oturpe/crystal-c-levitation/resources/wiki/schematics/magnet-above-feedback.jpg

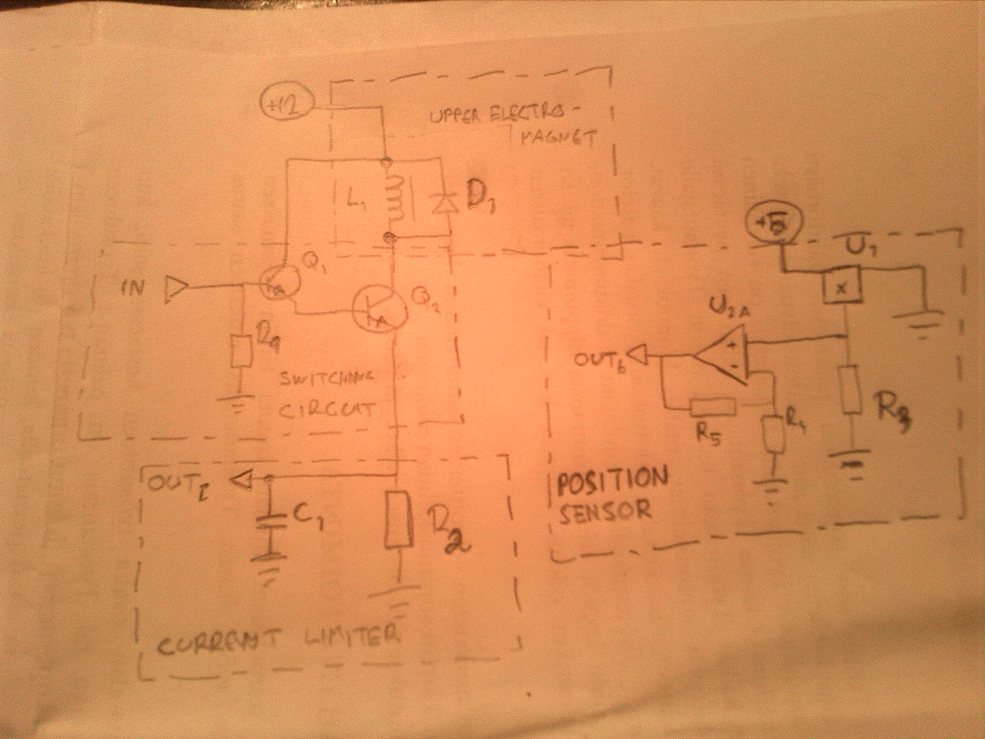
resources/wiki/schematics/magnet-above-feedback.jpg
