oturpe/crystal-c-levitation/resources/wiki/schematics/driver.jpg

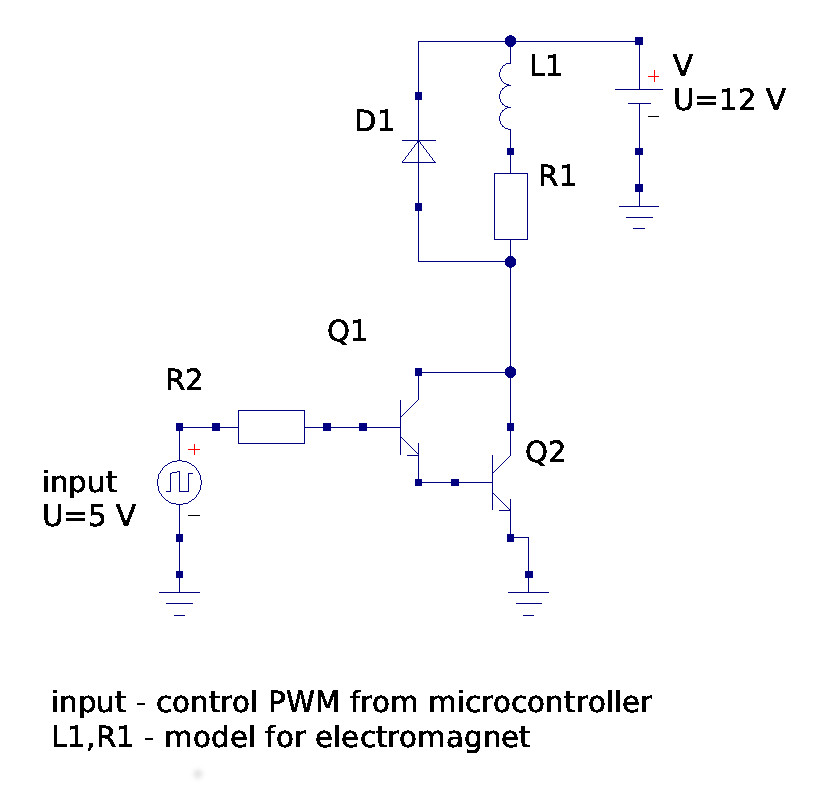
resources/wiki/schematics/driver.jpg
