oturpe/crystal-c-levitation/resources/wiki/schematics/sensor.jpg

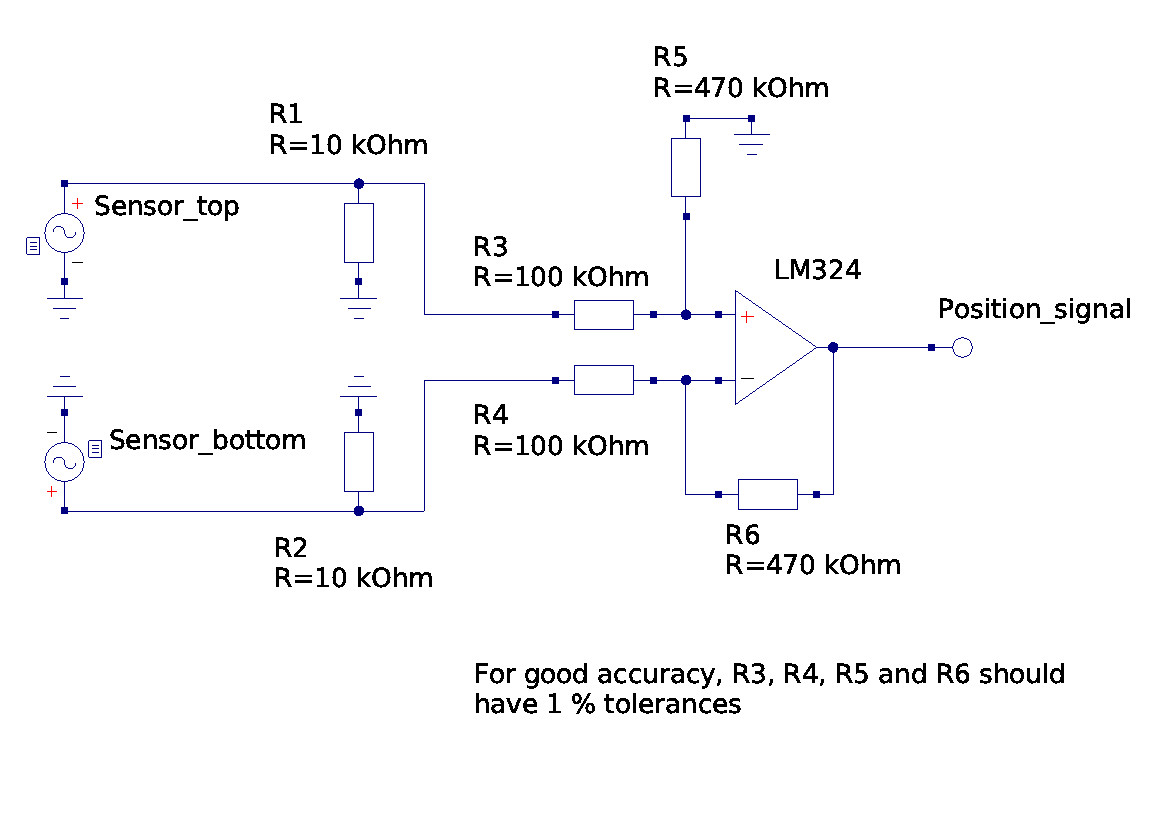
resources/wiki/schematics/sensor.jpg
