oturpe/crystal-c-levitation/resources/wiki/test-results/magnets.ods

id | wire | Resistance (Ω) | turns | Ratio (Ω/100 turns) | core Ø (mm) | Inductance (μH) | Notes
0/1 | broken power supply, thinner | 1,0 | 200 | 0,500 | 4
0/2 | broken power supply, thinner | 2,5 | 515 | 0,485 | 4 |  | Extension of the previous one
1/1 | Ø 0,2 mm | 7,7 | 515 | 1,495 | 3 |  | Too hot at 440 mA?
1/2 | Ø 0,2 mm | 23,5 | 1500 | 1,567 | 3
2/1 | Ø 0,4 mm | 15,0 | 2010 | 0,746 | 5
3/1 | Ø 0,6 mm | 9,4 | 1850 | 0,508 | 5 | 23 (assume air core)
4/1 | Ø 1,0 mm | 4,2 | ? | #ARVO! | 9
4/2 | Ø 1,0 mm | 4,2 | 1630 | 0,258 | 10 |  | Adjustable core
4/3 | Ø 1,0 mm | 8,1 | 2540 | 0,319 | 10 |  | Adjustable core. Extension of the previous one
 |  |  |  | #JAKO/0!
 |  |  |  | #JAKO/0!
 |  |  |  | #JAKO/0!
 |  |  |  | #JAKO/0!
 |  |  |  | #JAKO/0!
 |  |  |  | #JAKO/0!
 |  |  |  | #JAKO/0!
 |  |  |  | #JAKO/0!
 |  |  |  | #JAKO/0!
 |  |  |  | #JAKO/0!
 |  |  |  | #JAKO/0!
 |  |  |  | #JAKO/0!
 |  |  |  | #JAKO/0!
 |  |  |  | #JAKO/0!
 |  |  |  | #JAKO/0!
 |  |  |  | #JAKO/0!
 |  |  |  | #JAKO/0!
