oturpe/crystal-c-levitation/resources/wiki/test-results/two_sensors.ods

Readings from both bottom and top Hall effect sensors using various duty cycle values.
Difference between these values is also reported. In ideal situation the difference is always zero.
Positioning of the sensors was done by first putting top one in the center and then matching bottom one so that values were as close as possible at 255 duty cycle.
Magnet used was 3/1, supply voltage 12 V.
duty cycle | bottom position | top position | diff
0 | 505 | 519 | 14
5 | 505 | 519 | 14
10 | 510 | 525 | 15
15 | 512 | 530 | 18
20 | 515 | 534 | 19
25 | 519 | 539 | 20
30 | 522 | 544 | 22
35 | 527 | 550 | 23
40 | 531 | 555 | 24
45 | 536 | 560 | 24
50 | 541 | 565 | 24
55 | 547 | 571 | 24
60 | 552 | 576 | 24
65 | 558 | 581 | 23
70 | 565 | 586 | 21
75 | 571 | 591 | 20
80 | 577 | 596 | 19
85 | 583 | 601 | 18
90 | 590 | 607 | 17
95 | 596 | 611 | 15
100 | 602 | 616 | 14
105 | 608 | 621 | 13
110 | 614 | 626 | 12
115 | 620 | 630 | 10
120 | 626 | 635 | 9
125 | 631 | 640 | 9
130 | 637 | 644 | 7
135 | 642 | 649 | 7
140 | 648 | 653 | 5
145 | 653 | 657 | 4
150 | 658 | 662 | 4
155 | 663 | 666 | 3
160 | 668 | 670 | 2
165 | 672 | 675 | 3
170 | 676 | 678 | 2
175 | 681 | 682 | 1
180 | 685 | 687 | 2
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
