oturpe/crystal-c-levitation/resources/wiki/test-results/position_pwm.ods

Position readings using various PWM frequencies as allowed by AVR
Values starting from 31250 and going down were taken using the same PWM pin (11) and reducing timer frequency
As maximum PWM frequency of pin 11 was 31250, values for 62500 were taken from pin 6
Note how variance of change attains its minumum at 3906 Hz
Variance is also calculated for range of 200-255 only as it is probably a good idea to drive magnet near full power at all times so as to get along with smaller magnet
duty cycle | Position 62500 | Position 31250 | Position 3906 | Position 977 | Position 488 | Position 122 | Δ 62500 | Δ 31250 | Δ 3906 | Δ 977 | Δ 488 | Δ 122
0 | 508 | 507 | 508 | 508 | 508 | 507
5 | 508 | 508 | 508 | 508 | 508 | 507 | 0 | 1 | 0 | 0 | 0 | 0
10 | 514 | 516 | 512 | 510 | 510 | 510 | 6 | 8 | 4 | 2 | 2 | 3
15 | 520 | 523 | 515 | 514 | 514 | 514 | 6 | 7 | 3 | 4 | 4 | 4
20 | 527 | 529 | 519 | 518 | 516 | 516 | 7 | 6 | 4 | 4 | 2 | 2
25 | 533 | 535 | 524 | 521 | 520 | 523 | 6 | 6 | 5 | 3 | 4 | 7
30 | 539 | 539 | 528 | 526 | 526 | 527 | 6 | 4 | 4 | 5 | 6 | 4
35 | 545 | 545 | 533 | 530 | 529 | 527 | 6 | 6 | 5 | 4 | 3 | 0
40 | 551 | 549 | 538 | 534 | 533 | 537 | 6 | 4 | 5 | 4 | 4 | 10
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
