oturpe/crystal-c-levitation/resources/wiki/test-results/position_2-1.ods

This table contains position readings directly from sensor connected right on the end of magnet 2/1.
U= 20V, PWM frequency = 122 Hz
Position ↑ is when text on the sensor (SE49) points toward the magnet core. Position ↓ is the opposite.
Quiescent reading is position reading when electromagnet is not powered.
Deviation is difference from quiescent reading.
Δ is change in value since the last reading.
Notice how absolute value of Δ varies with duty cycle, but is same for both ↑ and ↓. Duty cycle.
This means that sensor in accurate, but magnetic field changes in a complicated way related to duty cycle.
Suspect: Timings of duty cycle and sensor reads interfere,
Suggestion 1: Increase PWM frequency (careful not to deprive electromagnet of time to release current!)
Suggestion 2: When reading the sensor, take multiple readings & average out.
quiescent | 507
duty cycle | Position ↑ | Position ↓ | Deviation ↑ | Deviation ↓ | Δ ↑ | Δ ↓ | Sum of deviations
0 | 507 | 507 | 0 | 0 |  |  | 0
10 | 507 | 507 | 0 | 0 | 0 | 0 | 0
20 | 501 | 511 | 6 | -4 | -6 | 4 | 2
30 | 489 | 523 | 18 | -16 | -12 | 12 | 2
40 | 470 | 542 | 37 | -35 | -19 | 19 | 2
50 | 473 | 539 | 34 | -32 | 3 | -3 | 2
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
