oturpe/crystal-c-levitation/resources/wiki/test-results/position_avg.ods

Position readings got by using different amount of smoothing of sensor readings.
In each case, sensor was read repeatedly with 10 ms intervals. Readings were taken 1, 2, 3, 4, 5, 6, 10 or 20 times.
Listed are raw position values got this way and differential between two subsequent values of duty cycle.
The interesting result is the variance of readings.
Results seem to indicate that some amount of smoothing is useful, but the effect is not huge.
duty cycle | Position 1 | Position 2 | Position 3 | Position 4 | Position 5 | Position 6 | Position 10 | Position 20 | Δ 1 | Δ 2 | Δ 3 | Δ 4 | Δ 5 | Δ 6 | Δ 10 | Δ 20
0 | 507 | 507 | 507 | 506 | 507 | 506 | 506 | 507
5 | 507 | 506 | 505 | 505 | 504 | 504 | 503 | 501 | 0 | -1 | -2 | -1 | -3 | -2 | -3 | -6
10 | 499 | 499 | 499 | 498 | 498 | 497 | 497 | 496 | -8 | -7 | -6 | -7 | -6 | -7 | -6 | -5
15 | 494 | 495 | 494 | 494 | 493 | 493 | 492 | 492 | -5 | -4 | -5 | -4 | -5 | -4 | -5 | -4
20 | 490 | 490 | 490 | 490 | 488 | 488 | 488 | 487 | -4 | -5 | -4 | -4 | -5 | -5 | -4 | -5
25 | 485 | 486 | 485 | 485 | 483 | 483 | 483 | 482 | -5 | -4 | -5 | -5 | -5 | -5 | -5 | -5
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
