oturpe/crystal-c-levitation/resources/wiki/test-results/field_strength.ods

Both bottom and top position readings using various supply voltages.
Magnet used was 3/1, supply voltages 12 V, 20 V and 27 V were used.
Notice how position difference values depend on magnetic fied strength (i.e. In all tests smallest difference appeared around position 700).
This may be because sensor positions were calibrated using field of that strength.
Also note the plot below showing how after value 700 readings smoothly change slower.
Reason for this change might be: i) high coil inductance, ii) sensor nonlinearity, iii) core saturation
duty cycle | bottom pos 12 | top pos 12 | pos diff 12 | Δ b pos 12 | bottom pos 20 | top pos 20 | pos diff 20 | Δ b pos 20 | bottom pos 27 | top pos 27 | pos diff 27 | Δ b pos 27
0 | 507 | 520 | -13 |  | 506 | 520 | -14 |  | 507 | 520 | -13
5 | 507 | 520 | -13 | 0 | 506 | 520 | -14 | 0 | 507 | 521 | -14 | 0
10 | 510 | 526 | -16 | 3 | 514 | 532 | -18 | 8 | 518 | 537 | -19 | 11
15 | 513 | 530 | -17 | 3 | 520 | 541 | -21 | 6 | 526 | 548 | -22 | 8
20 | 516 | 534 | -18 | 3 | 527 | 550 | -23 | 7 | 536 | 558 | -22 | 10
25 | 519 | 539 | -20 | 3 | 536 | 559 | -23 | 9 | 547 | 569 | -22 | 11
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
