oturpe/crystal-c-levitation/src/main.cpp

// Precompiled library dependencies
#include "Arduino.h"
#include "new.h"

// Source library dependencies
#include "lib/ArduinoPwm.h"

// Project configuration
#include "CrystalCLevitation.h"

// In-project dependencies
#include "PositionSensor.h"
#include "RingDriver.h"
#include "Controller.h"

RingDriver ringDriver(RING_PIN);
PositionSensor positionSensor(SENSOR_PIN,SENSOR_RESET_PIN);
Controller controller(CONTROLLER_PIN_OP,CONTROLLER_PIN_COEFF);

int loopCount = 0;

// The setup() method runs once, when the sketch starts
void setup() {
   #ifdef __DEBUG
       Serial.begin(DEBUG_PRINT_BAUDRATE);
   #endif

   setPwmFrequency(RING_PIN,PWM_SCALING);

   ringDriver.init();

   // Header line for CSV debug output
   #ifdef __DEBUG
       Serial.println("position;duty cycle;");
   #endif
}

// the loop() method runs over and over again, as long as the Arduino has power.
void loop() {
    loopCount += 1;

    if(loopCount % CONTROLLER_PARAM_UPDATE_INTERVAL == 0) {
        controller.readParameters();
        positionSensor.readParameters();
    }

    int position = positionSensor.read();
    int level = controller.control(position);

    ringDriver.drive(level);

    // Add line to CSV debug output
    #ifdef __DEBUG
        if (loopCount % DEBUG_PRINT_INTERVAL == 0) {
            Serial.print(position);
            Serial.print(";");
            Serial.print(level);
            Serial.print(";");

            Serial.println("");
        }
    #endif
}

int main(void) {

    init();
    setup();

    while (true) {
        loop();
    }
}
