oturpe/crystal-c-levitation/src/RingDriver.cpp

/*
 * RingDriver.cpp
 *
 *  Created on: 5.11.2013
 *      Author: Otto Urpelainen
 */

#include "Arduino.h"

#include "CrystalCLevitation.h"

#include "RingDriver.h"

RingDriver::RingDriver(int ringPin): ringPin(ringPin) {
}

void RingDriver::init() {
    pinMode(ringPin,OUTPUT);
    analogWrite(ringPin,0);
}

void RingDriver::drive(int dutyCycle) {
    analogWrite(ringPin,dutyCycle);
}

RingDriver::RingDriver() {
}
