oturpe/crystal-c-levitation/(commit log)

2013-11-03 Init as AVR project that uses the Arduino Core library.
2013-11-04 Add schematics
2013-11-05 First code: simple ring driver and rudimentary debug logic
2013-11-10 Updated driver circuit schematic
    [driver.sch]
2013-11-10 Improved driver schematics
    [driver.sch]
2013-11-11 Add position sensor
2013-11-11 Add PWM frequency control from arduino.cc
2013-11-11 Fix compile errors + organize includes
    [PositionSensor.cpp, main.cpp]
2013-11-12 Add test results for position sensing
    [position_2-1.ods]
2013-11-12 Test results of various PWM freqs, select good value
    [position_pwm.ods]
2013-11-12 Smoothing of position samples
2013-11-14 Add position sensor test results
    [field_strength.ods, two_sensors.ods]
2013-11-14 Add position smoothing results
    [position_avg.ods]
2013-11-14 Make debug interfere less with actual functions.
    [CrystalCLevitation.h, main.cpp]
2013-11-15 Difference & amplify sensor values with opamp, software sees only one position value.
    [sensor.sch]
2013-11-19 Use fixed controller offset,simplifies interface
    [Controller.cpp, Controller.h, CrystalCLevitation.h, main.cpp]
2013-11-22 Change driver pin
2013-11-25 Add reset button
2013-11-27 Adjust PWm scaling to match new PWM pin
2013-12-04 New PWM frequency
2014-02-21 Add wiki resource for magnet values
    [magnets.ods]
